Narawit-Intusub/BoadV1/docs/renders/master_render_3d.png

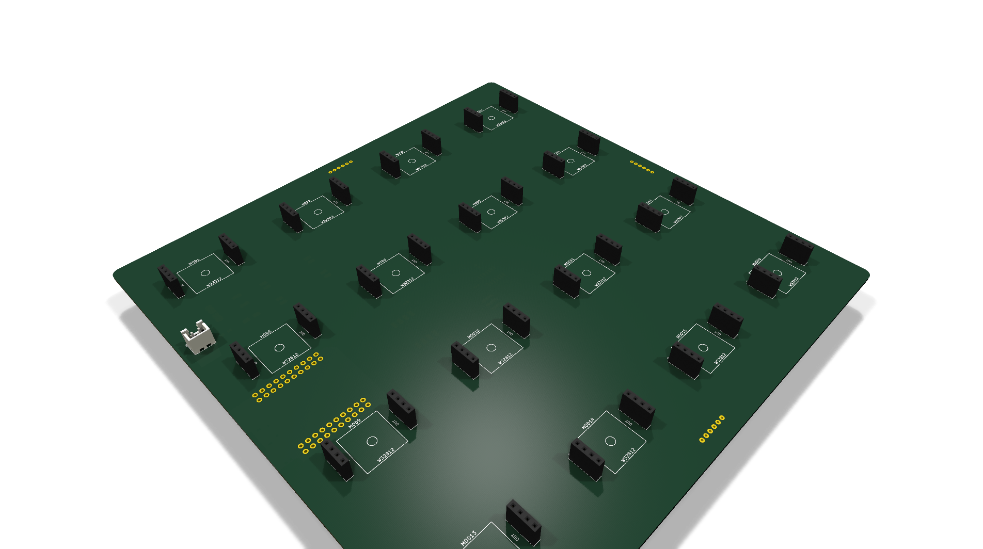
docs/renders/master_render_3d.png
