Narawit-Intusub/BoadV1/docs/renders/master_render_bottom.png

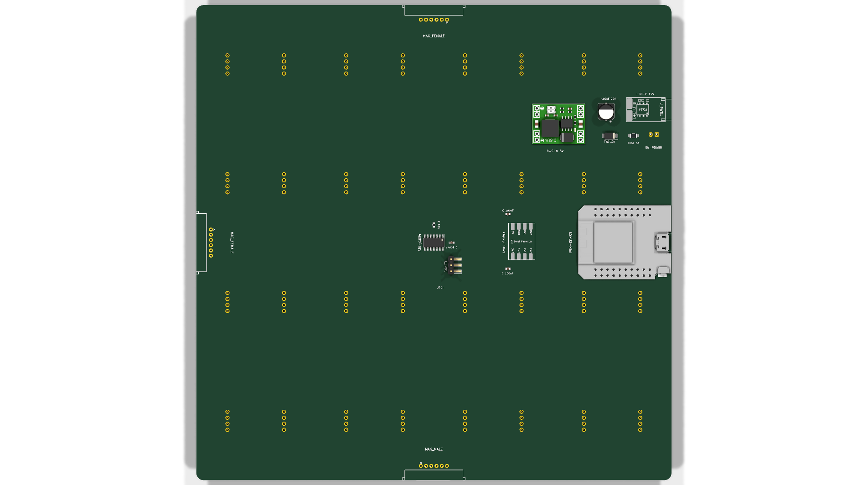
docs/renders/master_render_bottom.png
