Narawit-Intusub/BoadV1/docs/renders/master_render_top.png

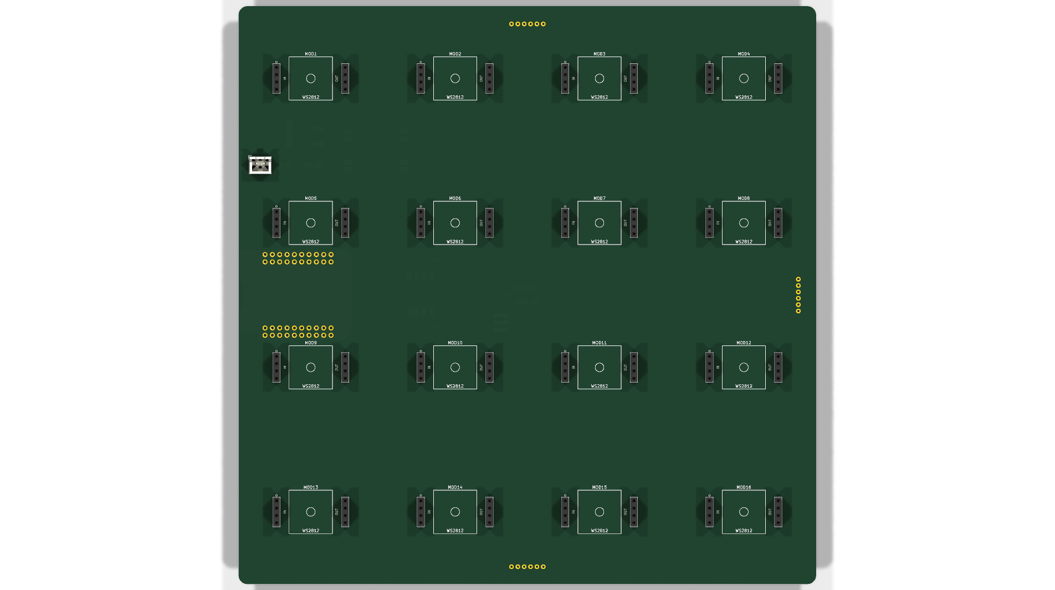
docs/renders/master_render_top.png
