Narawit-Intusub/BoadV1/hardware/experimental/master_esp32/master_esp32.pdf

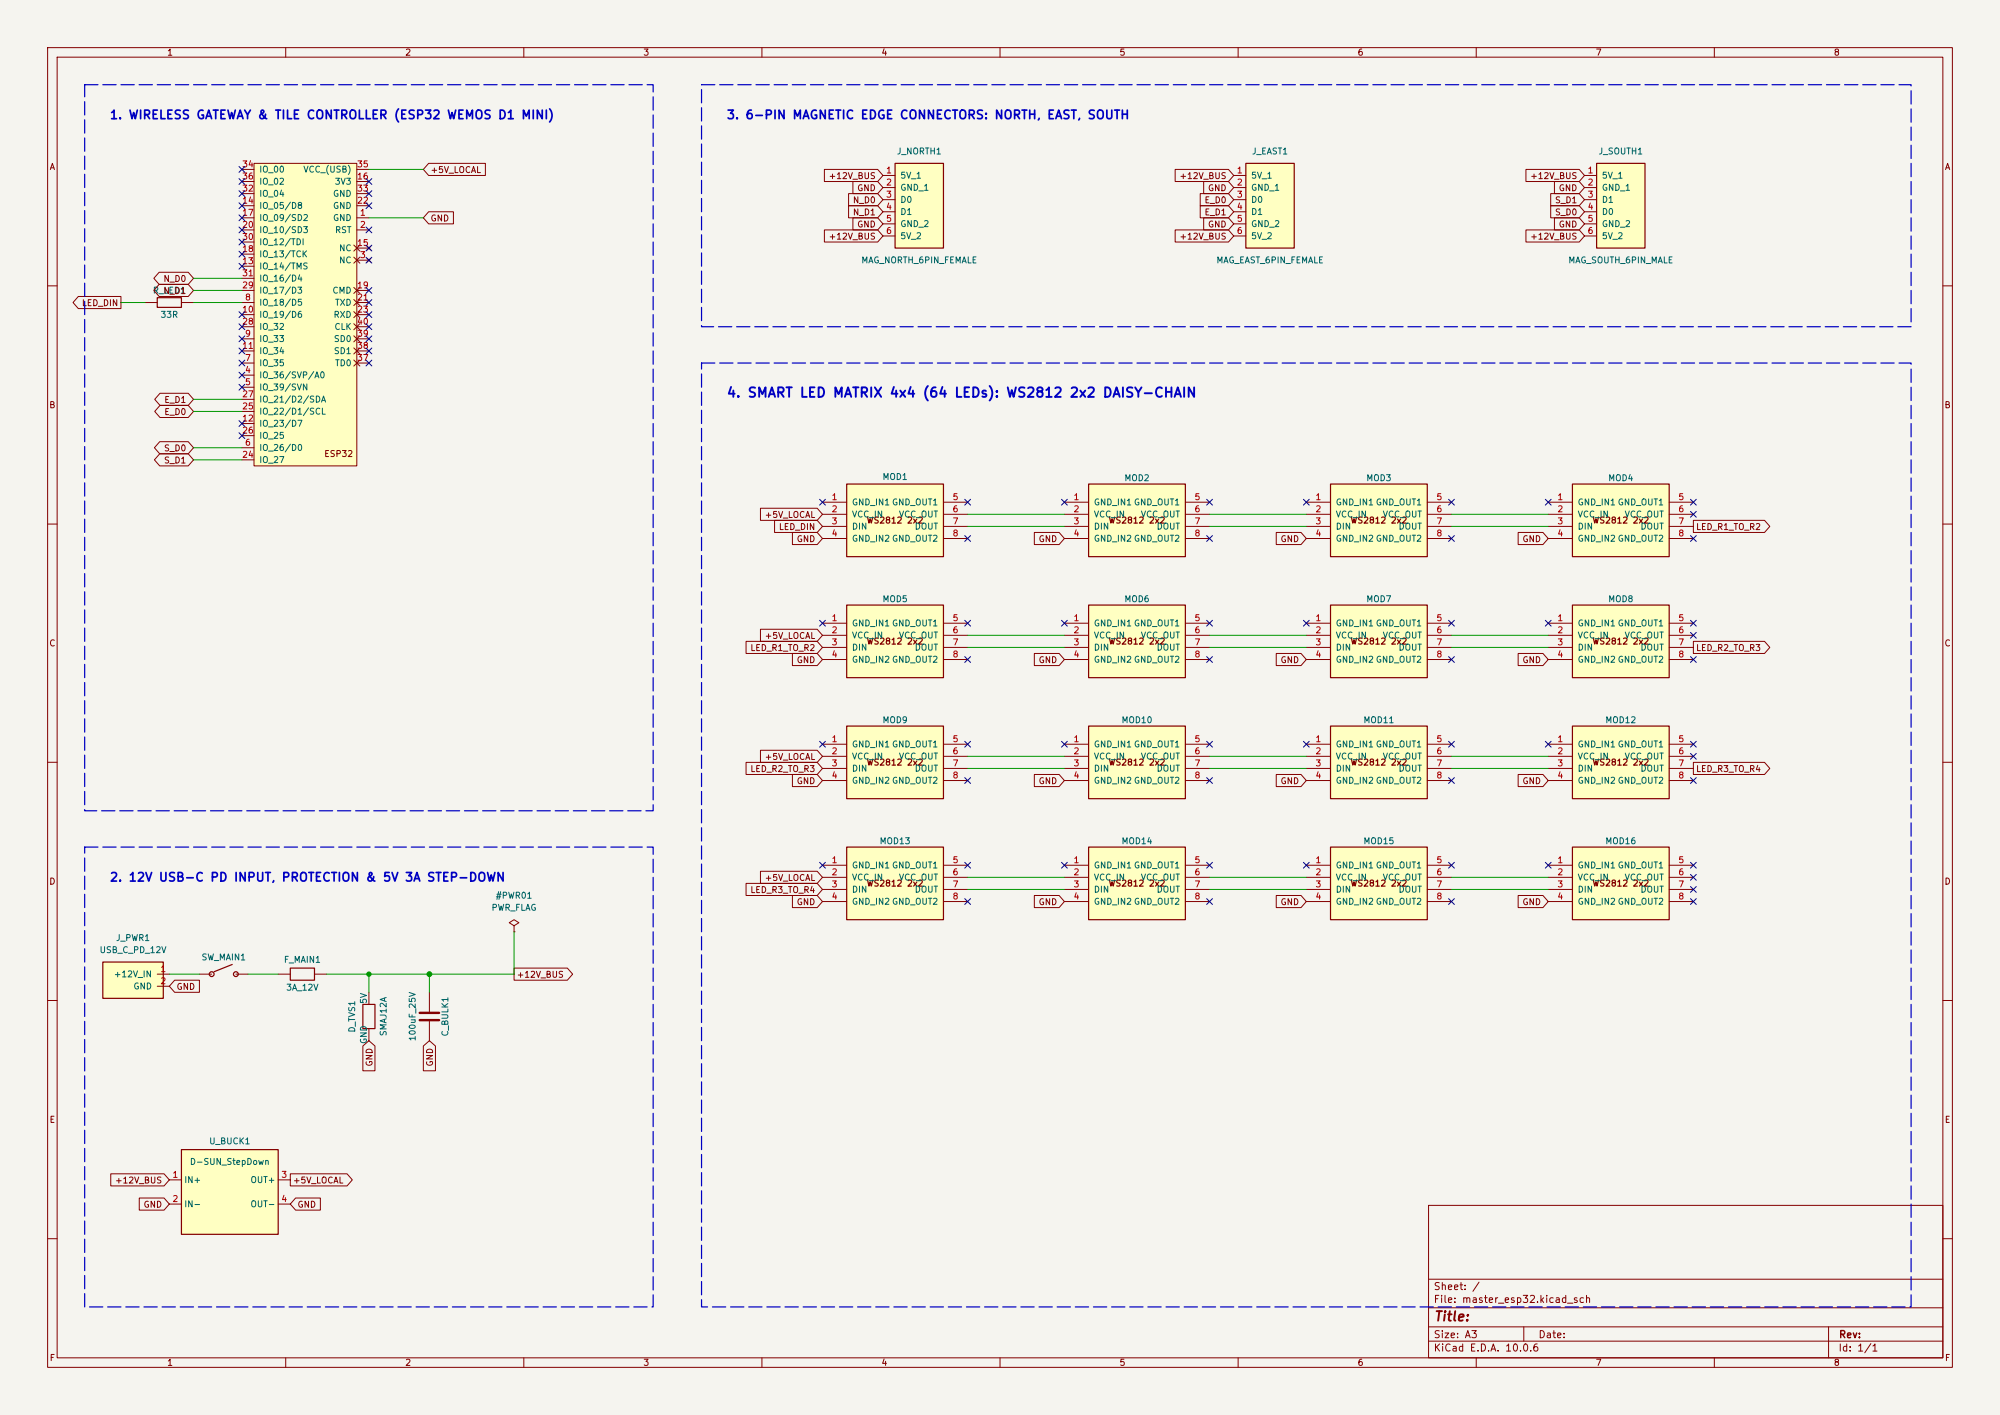
[picture p4: page 1]

4. SMART LED MATRIX 4x4 (64 LEDs): WS2812 2x2 DAISY-CHAIN

2. 12V USB-C PD INPUT, PROTECTION & 5V 3A STEP-DOWN

Size: A3 | Rev: | F Date:
KiCad E.D.A. 10.0.6 | Id: 1/1
