Narawit-Intusub/BoadV1/master/master.pdf

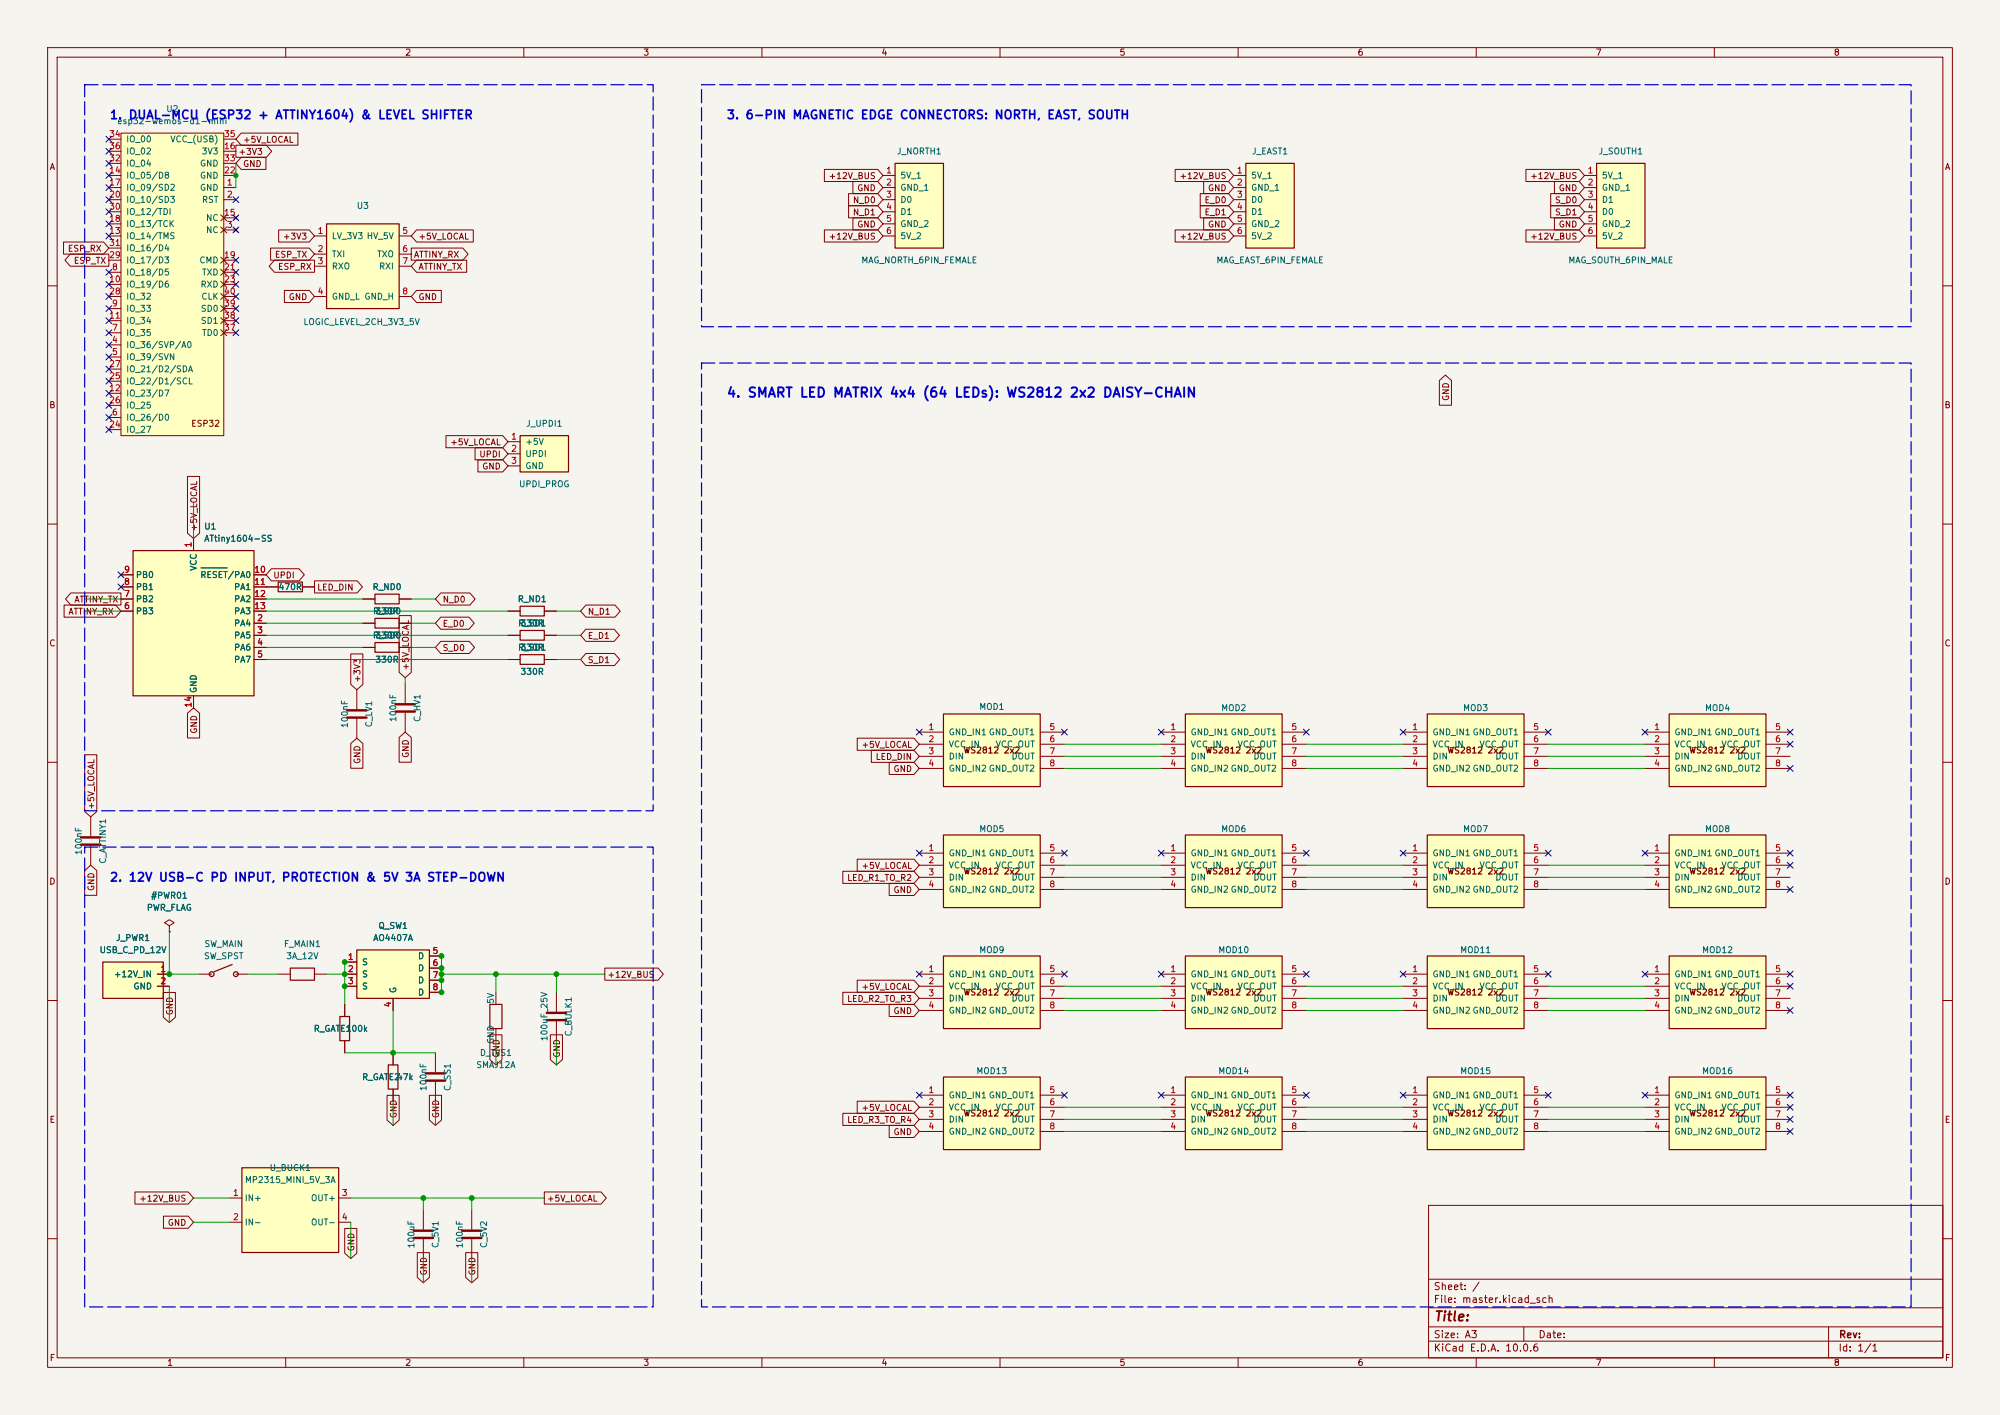
[picture p5: page 1]

4. SMART LED MATRIX 4x4 (64 LEDs): WS2812 2x2 DAISY-CHAIN

Size: A3 | Rev: | F Date:
KiCad E.D.A. 10.0.6 | Id: 1/1
