Narawit-Intusub/BoadV1/docs/pdf/rfid_addon.pdf

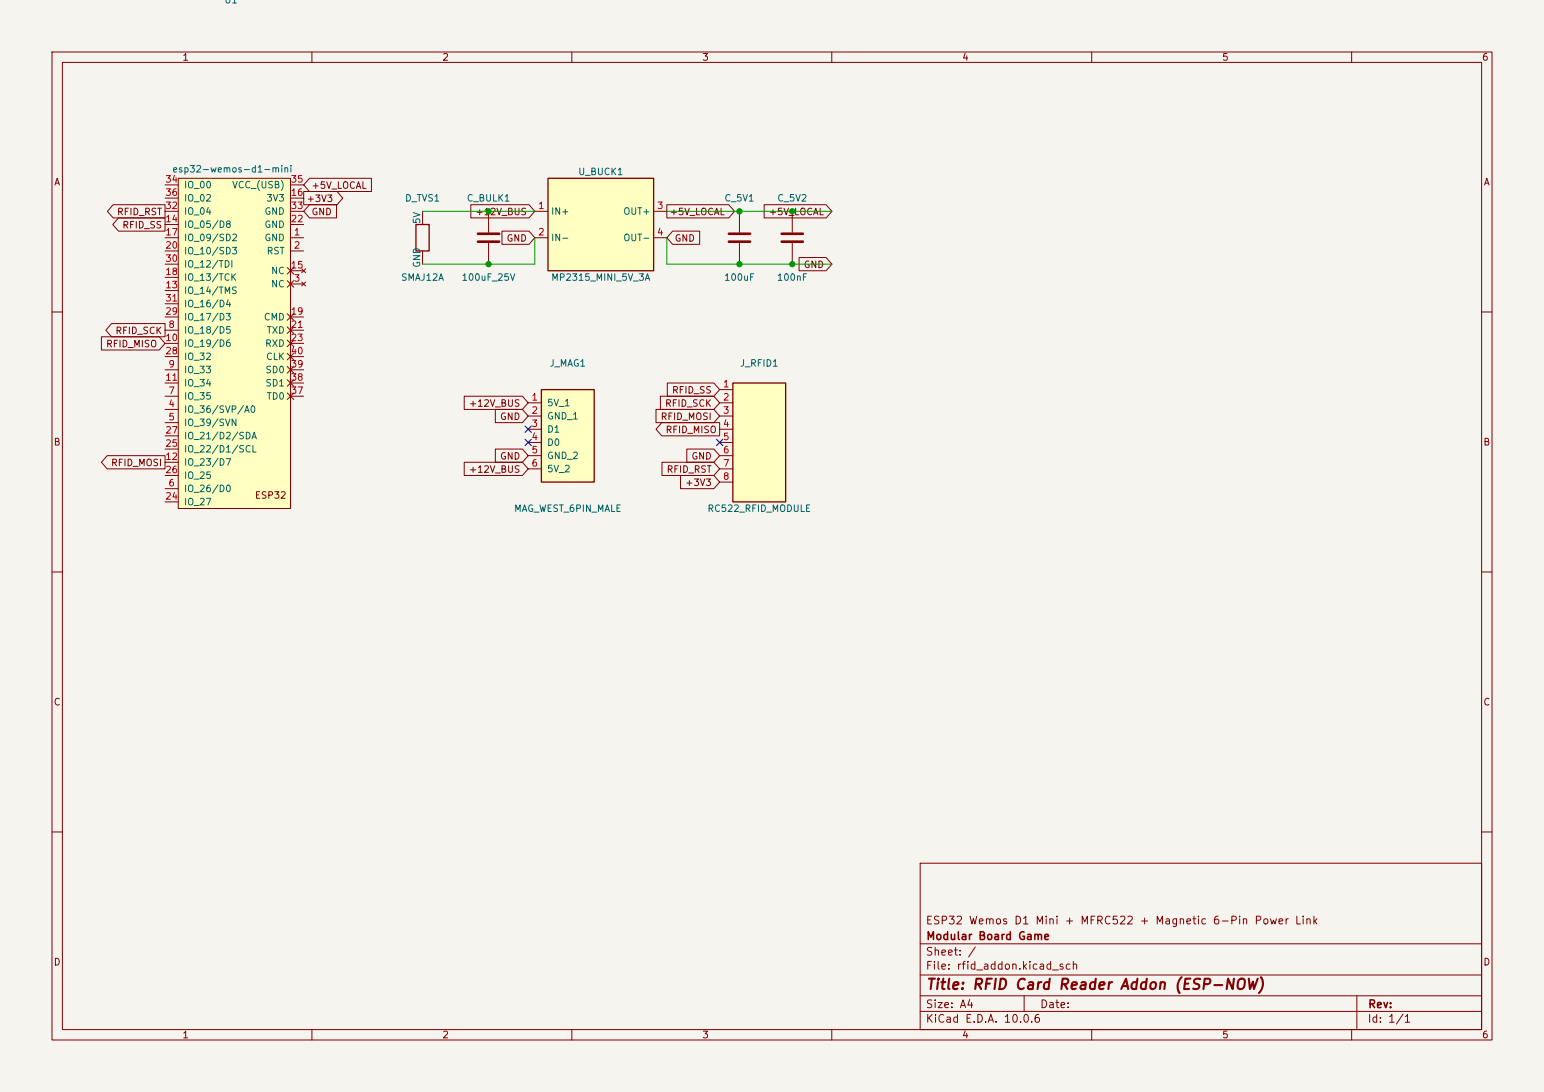
[picture p6: page 1]

ESP32 Wemos D1 Mini + MFRC522 + Magnetic 6-Pin Power Link
Modular Board Game
Sheet: /
File: rfid_addon.kicad_sch
Title: RFID Card Reader Addon (ESP-NOW)

Size: A4 | Rev:
KiCad E.D.A. 10.0.6 | Id: 1/1
