Narawit-Intusub/BoadV1/docs/pdf/slave.pdf

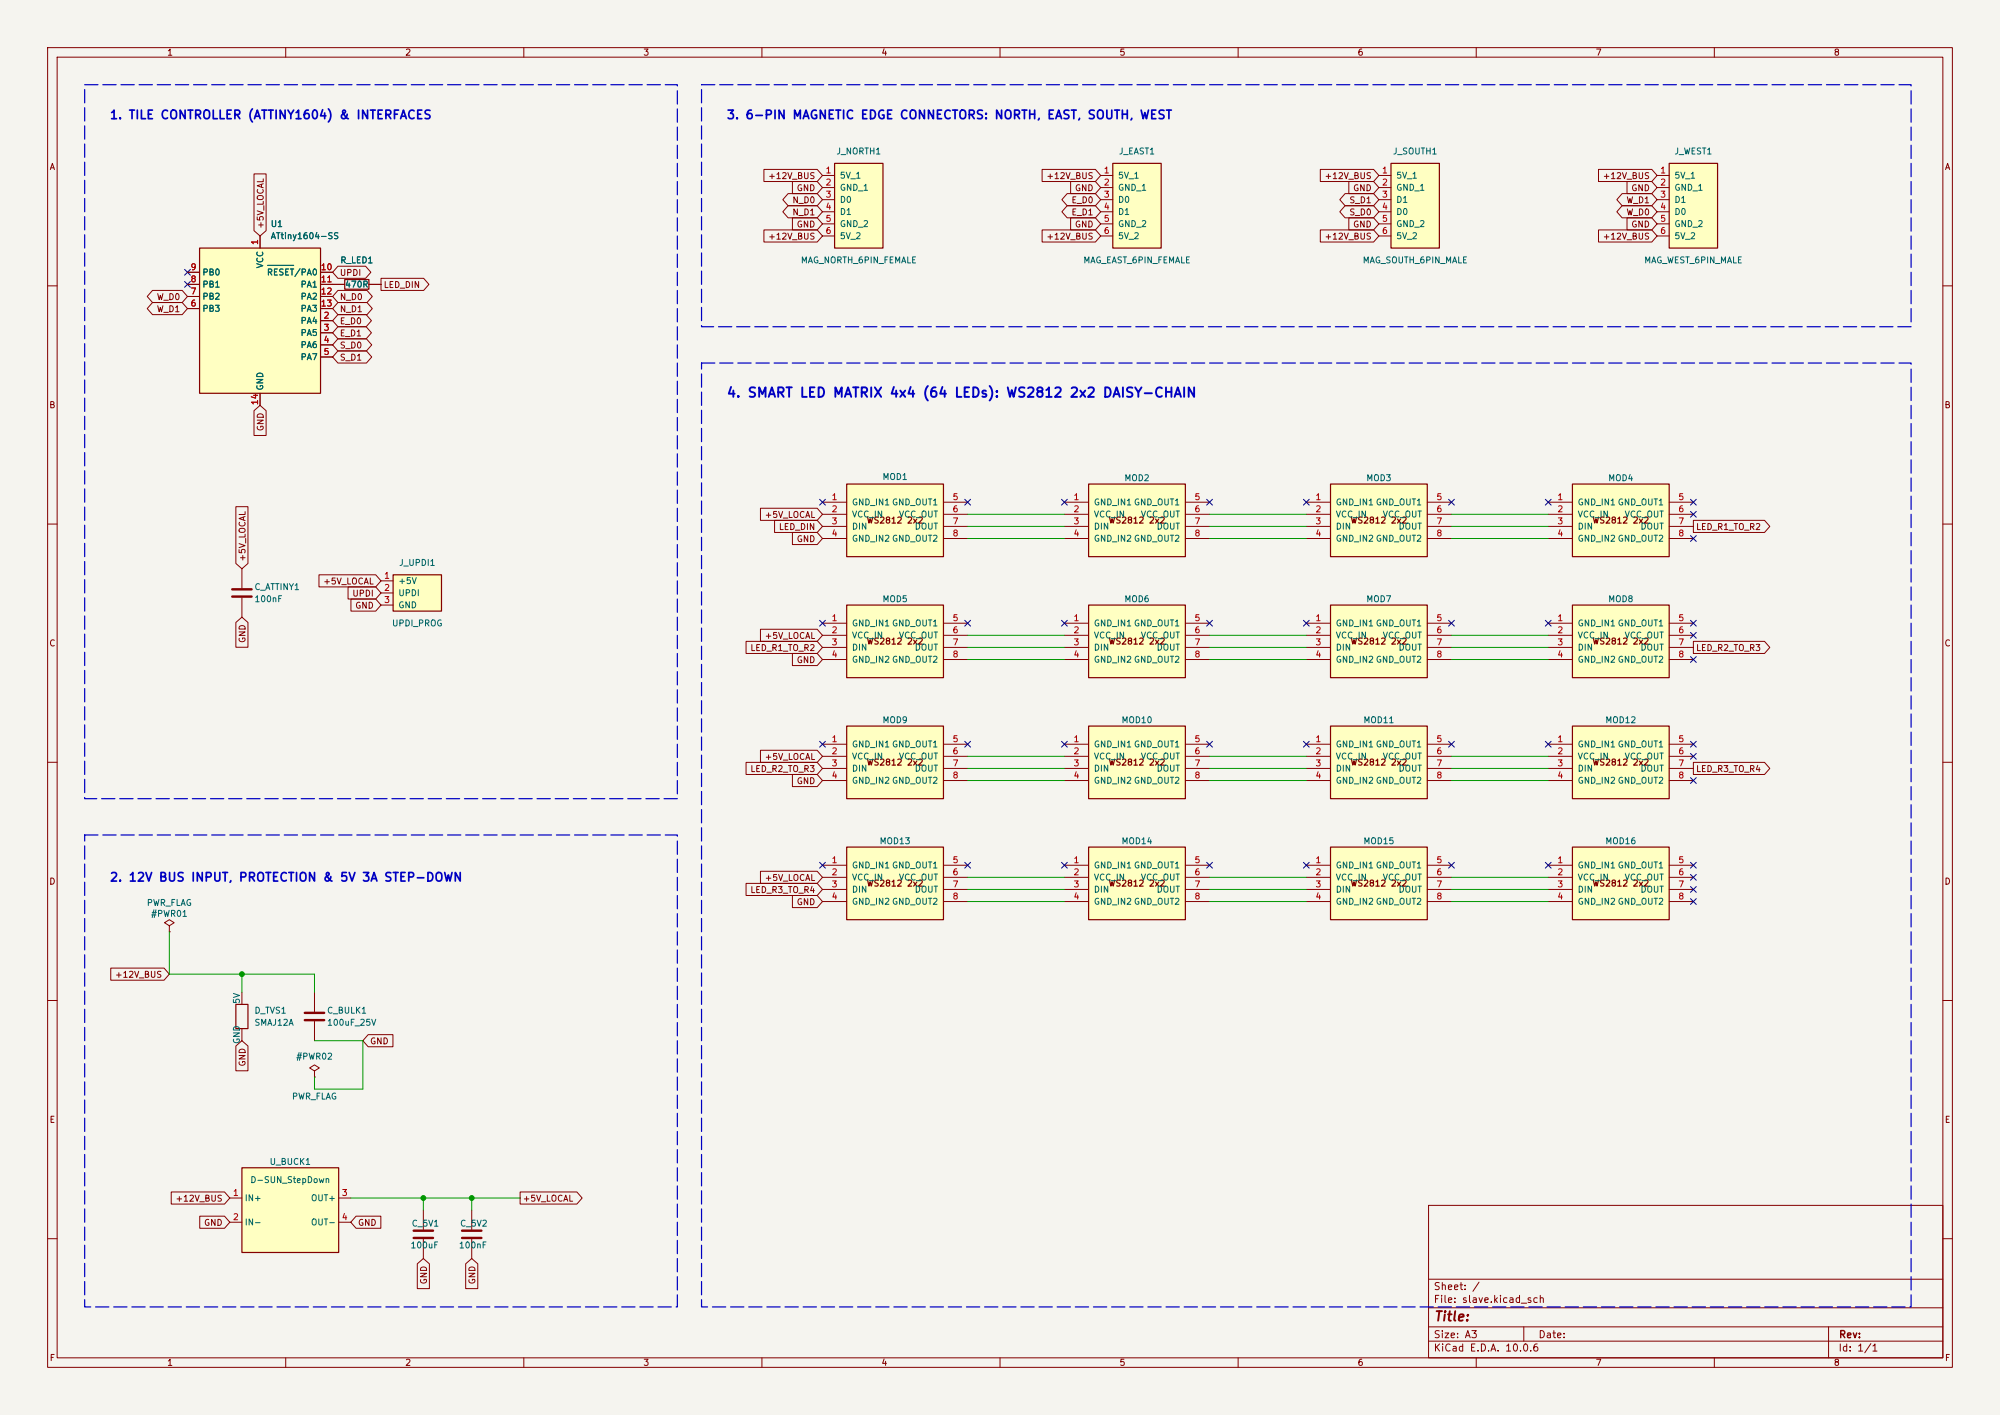
[picture p7: page 1]

3. 6-PIN MAGNETIC EDGE CONNECTORS: NORTH, EAST, SOUTH, WEST

4. SMART LED MATRIX 4x4 (64 LEDs): WS2812 2x2 DAISY-CHAIN

2. 12V BUS INPUT, PROTECTION & 5V 3A STEP-DOWN

Size: A3 | Rev: | F Date:
KiCad E.D.A. 10.0.6 | Id: 1/1
