Narawit-Intusub/BoadV1/master/master.kicad_sch

## KiCad design master/master.kicad_sch (2026-10-05)

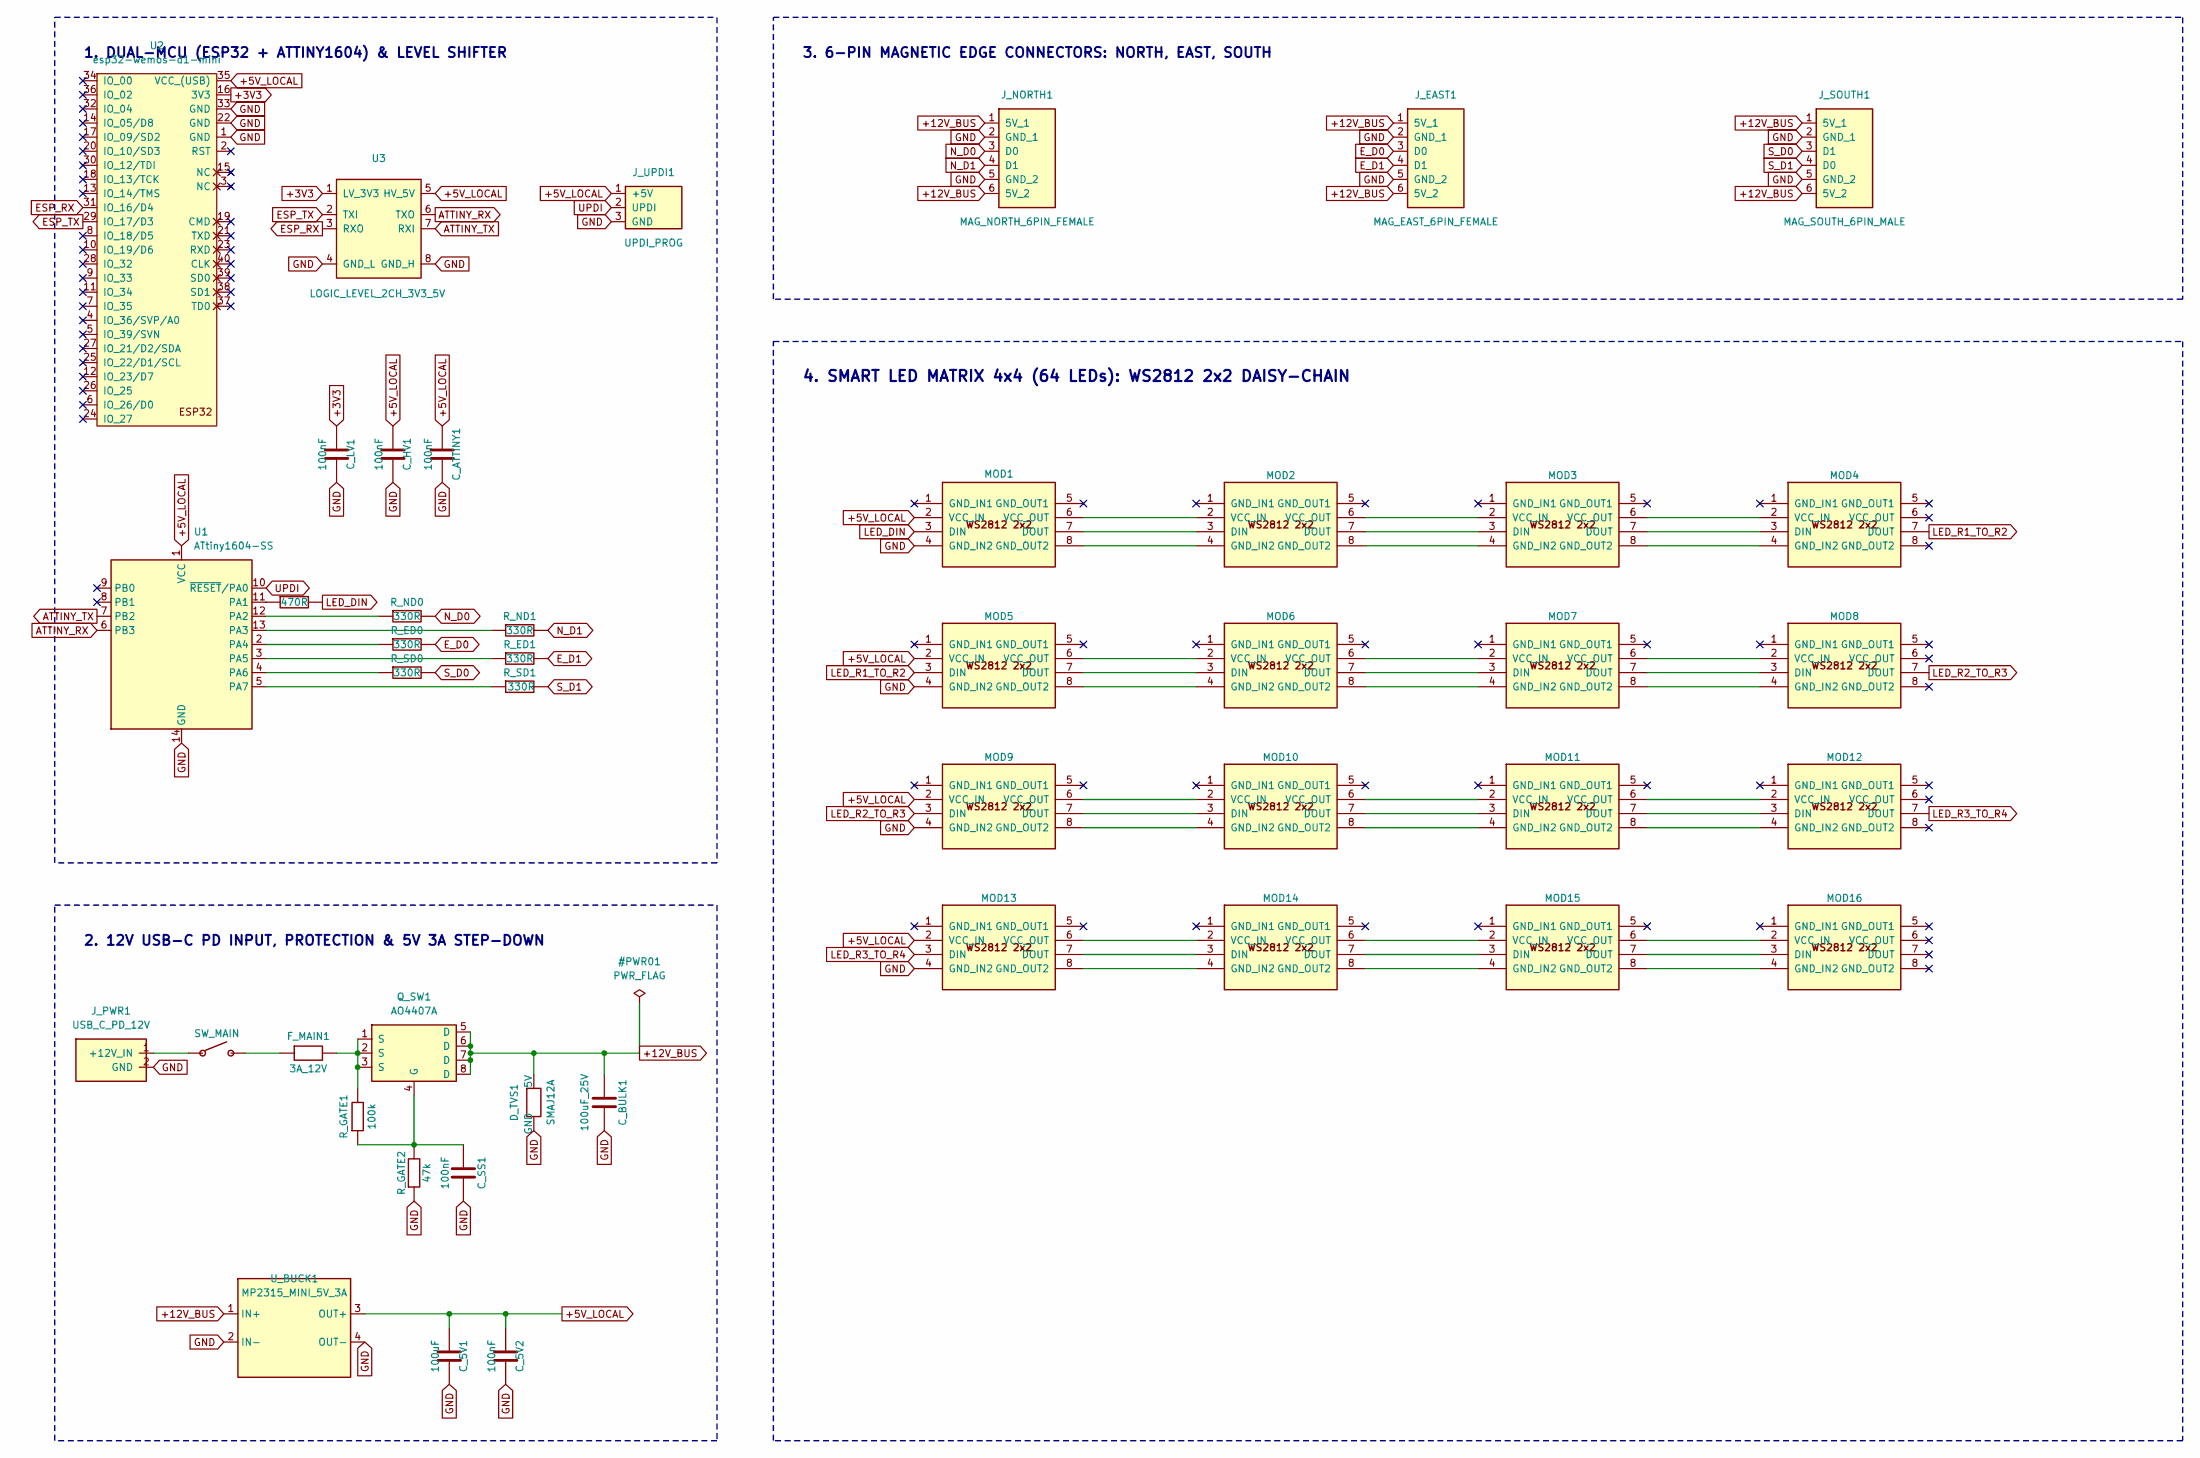
[picture p11: schematic master.kicad_sch]

Parts:
C_5V1: 100uF
C_5V2: 100nF
C_ATTINY1: 100nF; C_0603_1608Metric
C_BULK1: 100uF_25V
C_HV1: 100nF; C_0603_1608Metric
C_LV1: 100nF; C_0603_1608Metric
C_SS1: 100nF
D_TVS1: SMAJ12A
F_MAIN1: 3A_12V
J_EAST1: MAG_EAST_6PIN_FEMALE
J_NORTH1: MAG_NORTH_6PIN_FEMALE
J_PWR1: USB_C_PD_12V; USB_C_Receptacle_HRO_TYPE-C-31-M-12
J_SOUTH1: MAG_SOUTH_6PIN_MALE
J_UPDI1: UPDI_PROG; PinHeader_1x03_P2.54mm_Vertical
MOD1, MOD2, MOD3, MOD4, MOD5, MOD6, MOD7, MOD8, MOD9, MOD10, MOD11, MOD12, MOD13, MOD14, MOD15, MOD16: WS2812_Matrix_2x2; WS2812_Matrix_2x2_15x15mm
Q_SW1: AO4407A
R_ED0, R_ED1: 330R; R_0603_1608Metric
R_GATE1: 100k
R_GATE2: 47k
R_LED1: 470R; R_0603_1608Metric
R_ND0, R_ND1: 330R; R_0603_1608Metric
R_SD0, R_SD1: 330R; R_0603_1608Metric
SW_MAIN: SW_SPST
U1: ATtiny1604-SS; SOIC-14_3.9x8.7mm_P1.27mm
U2: esp32-wemos-d1-mini
U3: LOGIC_LEVEL_2CH_3V3_5V
U_BUCK1: MP2315_MINI_5V_3A; MP2315_Mini_StepDown

Connections:
+3V3: C_LV1.1, U2.16 (3V3), U3.1 (LV_3V3)
+5V_LOCAL: C_5V1.1, C_5V2.1, C_ATTINY1.1, C_HV1.1, J_UPDI1.1 (+5V), MOD1.2 (VCC_IN), MOD5.2 (VCC_IN), MOD9.2 (VCC_IN), MOD13.2 (VCC_IN), U1.1 (VCC), U2.35 (VCC_(USB)), U3.5 (HV_5V), U_BUCK1.3 (OUT+)
+12V_BUS: C_BULK1.1, D_TVS1.1 (5V), J_EAST1.1 (5V_1), J_EAST1.6 (5V_2), J_NORTH1.1 (5V_1), J_NORTH1.6 (5V_2), J_SOUTH1.1 (5V_1), J_SOUTH1.6 (5V_2), Q_SW1.5 (D), Q_SW1.6 (D), Q_SW1.7 (D), Q_SW1.8 (D), U_BUCK1.1 (IN+)
ATTINY_RX: U1.6 (PB3), U3.6 (TXO)
ATTINY_TX: U1.7 (PB2), U3.7 (RXI)
ESP_RX: U2.31 (IO_16/D4), U3.3 (RXO)
ESP_TX: U2.29 (IO_17/D3), U3.2 (TXI)
E_D0: J_EAST1.3 (D0), R_ED0.2
E_D1: J_EAST1.4 (D1), R_ED1.2
GND: C_5V1.2, C_5V2.2, C_ATTINY1.2, C_BULK1.2, C_HV1.2, C_LV1.2, C_SS1.2, D_TVS1.2 (GND), J_EAST1.2 (GND_1), J_EAST1.5 (GND_2), J_NORTH1.2 (GND_1), J_NORTH1.5 (GND_2), J_PWR1.2 (GND), J_SOUTH1.2 (GND_1), J_SOUTH1.5 (GND_2), J_UPDI1.3 (GND), MOD1.4 (GND_IN2), MOD5.4 (GND_IN2), MOD9.4 (GND_IN2), MOD13.4 (GND_IN2), R_GATE2.1, U1.14 (GND), U2.1 (GND), U2.22 (GND), U2.33 (GND), U3.4 (GND_L), U3.8 (GND_H), U_BUCK1.2 (IN-), U_BUCK1.4 (OUT-)
LED_DIN: MOD1.3 (DIN), R_LED1.2
LED_R1_TO_R2: MOD4.7 (DOUT), MOD5.3 (DIN)
LED_R2_TO_R3: MOD8.7 (DOUT), MOD9.3 (DIN)
LED_R3_TO_R4: MOD12.7 (DOUT), MOD13.3 (DIN)
N_D0: J_NORTH1.3 (D0), R_ND0.2
N_D1: J_NORTH1.4 (D1), R_ND1.2
unnamed: C_SS1.1, Q_SW1.4 (G), R_GATE1.1, R_GATE2.2
unnamed: F_MAIN1.1, SW_MAIN.2
unnamed: F_MAIN1.2, Q_SW1.1 (S), Q_SW1.2 (S), Q_SW1.3 (S), R_GATE1.2
unnamed: J_PWR1.1 (+12V_IN), SW_MAIN.1
unnamed: MOD1.6 (VCC_OUT), MOD2.2 (VCC_IN)
unnamed: MOD1.7 (DOUT), MOD2.3 (DIN)
unnamed: MOD1.8 (GND_OUT2), MOD2.4 (GND_IN2)
unnamed: MOD2.6 (VCC_OUT), MOD3.2 (VCC_IN)
unnamed: MOD2.7 (DOUT), MOD3.3 (DIN)
unnamed: MOD2.8 (GND_OUT2), MOD3.4 (GND_IN2)
unnamed: MOD3.6 (VCC_OUT), MOD4.2 (VCC_IN)
unnamed: MOD3.7 (DOUT), MOD4.3 (DIN)
unnamed: MOD3.8 (GND_OUT2), MOD4.4 (GND_IN2)
unnamed: MOD5.6 (VCC_OUT), MOD6.2 (VCC_IN)
unnamed: MOD5.7 (DOUT), MOD6.3 (DIN)
unnamed: MOD5.8 (GND_OUT2), MOD6.4 (GND_IN2)
unnamed: MOD6.6 (VCC_OUT), MOD7.2 (VCC_IN)
unnamed: MOD6.7 (DOUT), MOD7.3 (DIN)
unnamed: MOD6.8 (GND_OUT2), MOD7.4 (GND_IN2)
unnamed: MOD7.6 (VCC_OUT), MOD8.2 (VCC_IN)
unnamed: MOD7.7 (DOUT), MOD8.3 (DIN)
unnamed: MOD7.8 (GND_OUT2), MOD8.4 (GND_IN2)
unnamed: MOD9.6 (VCC_OUT), MOD10.2 (VCC_IN)
unnamed: MOD9.7 (DOUT), MOD10.3 (DIN)
unnamed: MOD9.8 (GND_OUT2), MOD10.4 (GND_IN2)
unnamed: MOD10.6 (VCC_OUT), MOD11.2 (VCC_IN)
unnamed: MOD10.7 (DOUT), MOD11.3 (DIN)
unnamed: MOD10.8 (GND_OUT2), MOD11.4 (GND_IN2)
unnamed: MOD11.6 (VCC_OUT), MOD12.2 (VCC_IN)
unnamed: MOD11.7 (DOUT), MOD12.3 (DIN)
unnamed: MOD11.8 (GND_OUT2), MOD12.4 (GND_IN2)
unnamed: MOD13.6 (VCC_OUT), MOD14.2 (VCC_IN)
unnamed: MOD13.7 (DOUT), MOD14.3 (DIN)
unnamed: MOD13.8 (GND_OUT2), MOD14.4 (GND_IN2)
unnamed: MOD14.6 (VCC_OUT), MOD15.2 (VCC_IN)
unnamed: MOD14.7 (DOUT), MOD15.3 (DIN)
unnamed: MOD14.8 (GND_OUT2), MOD15.4 (GND_IN2)
unnamed: MOD15.6 (VCC_OUT), MOD16.2 (VCC_IN)
unnamed: MOD15.7 (DOUT), MOD16.3 (DIN)
unnamed: MOD15.8 (GND_OUT2), MOD16.4 (GND_IN2)
unnamed: R_ED0.1, U1.2 (PA4)
unnamed: R_ED1.1, U1.3 (PA5)
unnamed: R_LED1.1, U1.11 (PA1)
unnamed: R_ND0.1, U1.12 (PA2)
unnamed: R_ND1.1, U1.13 (PA3)
unnamed: R_SD0.1, U1.4 (PA6)
unnamed: R_SD1.1, U1.5 (PA7)
S_D0: J_SOUTH1.3 (D1), R_SD0.2
S_D1: J_SOUTH1.4 (D0), R_SD1.2
UPDI: J_UPDI1.2 (UPDI), U1.10 (~RESET/PA0)

Notes on the sheet:
1. DUAL-MCU (ESP32 + ATTINY1604) & LEVEL SHIFTER
2. 12V USB-C PD INPUT, PROTECTION & 5V 3A STEP-DOWN
3. 6-PIN MAGNETIC EDGE CONNECTORS: NORTH, EAST, SOUTH
4. SMART LED MATRIX 4x4 (64 LEDs): WS2812 2x2 DAISY-CHAIN
