Narawit-Intusub/BoadV1/(commit log)

2026-10-05 feat(slave): add complete slave board schematic and project configuration
2026-10-05 feat(slave): export schematic to PDF and resolve ERC violations
2026-10-05 chore(slave): update schematic and re-export slave.pdf
2026-10-26 feat(hardware): reorganize project structure, add master PCB, and update component libraries
2026-10-26 docs: update schematic PDFs and high-res PCB 3D renders
2026-10-28 feat: add hardware firmware suite and update KiCad master/slave PCB designs
2026-11-03 feat(hardware): update master PCB routing with wider CNC traces, enlarged THT drills, and larger vias
2026-11-03 feat(hardware,production): update master PCB layout, gerber outputs, and CNC milling files
2026-11-03 refactor(firmware): ขจัดความซ้ำซ้อนเฟิร์มแวร์ แยกบทบาท ATtiny1604 เป็น Pure Driver และรองรับคำสั่งไร้สายครบวงจร
